IZ-Labs/RingRewards/README.md

# Welcome to Ring Rewards!
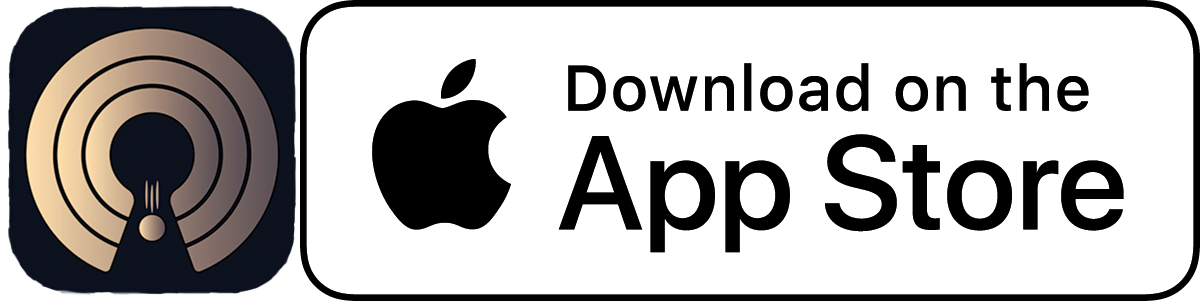
[picture p1: RingRewardsAppStoreBadge.png]


This is Ring Rewards, an IOS app that syncs your activity data using Apple's HealthKit, and uses that to determine if you've earned a candy reward.

<p>This is the culmination of about a project I've been working on in the background (very much on and off again) for over a year. It started as a 1 week design sprint during Mark Rober's Creative Engineering class on Studio, but ended up being a project that inspired me to learn how to make a PCB, how to program and release an IOS app with Swift and much much more.&nbsp;</p>
<p>The IOS app to accompany this device is available on the <a href="https://apps.apple.com/us/app/ring-rewards/id1584007591" target="_blank">App Store worldwide</a>, and the PCB Gerber files along with Arduino code are available on the linked <a href="https://github.com/CaptainZ1/RingRewards" target="_blank">GitHub repo.</a></p>
<p>The full video describing the design and build process is available here:</p>

<iframe width="560" height="315" src="https://www.youtube.com/embed/Qt_wYOnrX2E" title="YouTube video player" frameborder="0" allow="accelerometer; autoplay; clipboard-write; encrypted-media; gyroscope; picture-in-picture" allowfullscreen></iframe>

<p>The dispenser itself was designed with peanut covered MnMs in mind (who's non-uniform proportions really messed with my head for a while when focusing on one idea…), but the design should be <i>relatively</i> easily adapted to any similar sized candy.&nbsp;</p>
<p>In addition, I would encourage anyone who's interested in a fun project to try and design their own candy dispenser mechanics to go along with my app. It's a great intro project and will be a fun piece to have around.</p>

All models can be found on my printables.com page here: https://www.printables.com/model/229330-apple-fitness-candy-dispenser-ring-rewards

<p><strong>Build Instructions/BOM:</strong>&nbsp;</p>
<div class="table-wrapper"><figure class="table"><table><thead><tr><th>#</th><th>Part</th><th>QTY</th><th>Link (if applicable)</th><th>Material</th></tr></thead><tbody><tr><th>1</th><td style="text-align: center;">Front Body Panel</td><td style="width: 10px; text-align: center;">1</td><td style="width: 300px;">Printed Part</td><td style="width: 90px; text-align: center;">PLA</td></tr><tr><th>2</th><td style="text-align: center;">Rear Body Panel</td><td style="text-align: center;">1</td><td>Printed Part</td><td style="text-align: center;">PLA</td></tr><tr><th>3</th><td style="text-align: center;">Primary Dispenser Knob/Gear</td><td style="text-align: center;">1</td><td>Printer Part</td><td style="text-align: center;">PLA</td></tr><tr><th>4</th><td style="text-align: center;">28BYJ-48 &nbsp;ULN2003 &nbsp;5V Stepper Motor</td><td style="text-align: center;">1</td><td>Find the cheapest/easiest you can. They're everywhere</td><td style="text-align: center;">N/A</td></tr><tr><th>5</th><td style="text-align: center;">Secondary Dispenser Knob/Gear</td><td style="text-align: center;">1</td><td>Printed Part</td><td style="text-align: center;">PLA</td></tr><tr><th>6</th><td style="text-align: center;">Acrylic Panel</td><td style="text-align: center;">1</td><td>Laser Cut/Hand Cut</td><td style="text-align: center;">Acrylic</td></tr><tr><th>7</th><td style="text-align: center;">16mm Latching Push Button Switch</td><td style="text-align: center;">1</td><td>Find the cheapest/easiest you can. They're everywhere</td><td style="text-align: center;">N/A</td></tr><tr><th>8</th><td style="text-align: center;">Electronics PCB</td><td style="text-align: center;">1</td><td><a href="https://github.com/CaptainZ1/RingRewards/tree/main/PCB%20Files" target="_blank">Order From these files or use breadboard.</a></td><td style="text-align: center;">N/A</td></tr><tr><th>9</th><td style="text-align: center;">M3x0.5x6mm Screws</td><td style="text-align: center;">6</td><td><a href="https://www.mcmaster.com/97763A812/" target="_blank">McMaster</a>&nbsp;</td><td style="text-align: center;">18-8</td></tr><tr><th>10</th><td style="text-align: center;">M3 Heat Set Inserts</td><td style="text-align: center;">6</td><td><a href="https://www.mcmaster.com/94459A130/" target="_blank">McMaster</a></td><td style="text-align: center;">Brass</td></tr><tr><th>11</th><td style="text-align: center;">Loading Cap</td><td style="text-align: center;">1</td><td>Printed Part</td><td style="text-align: center;">TPU</td></tr><tr><th>12</th><td style="text-align: center;">Jam Clearing Rod</td><td style="text-align: center;">1</td><td>Printed Part</td><td style="text-align: center;">PLA</td></tr><tr><th>13</th><td style="text-align: center;">Jam Rod Retainer</td><td style="text-align: center;">1</td><td>Printed Part</td><td style="text-align: center;">PLA/PETG</td></tr><tr><th>14</th><td style="text-align: center;">Jam Rod Spring</td><td style="text-align: center;">1</td><td>8-10mm ID, &gt;20mm free length MIN</td><td style="text-align: center;">Misc. Metal</td></tr><tr><th>15</th><td style="text-align: center;">Command Strips</td><td style="text-align: center;">5</td><td>Velcro style 2-part command steps or similar</td><td style="text-align: center;">Adhesive</td></tr><tr><th>16</th><td style="text-align: center;">Superglue</td><td style="text-align: center;">N/A</td><td>Superglue or desired permanent adhesive</td><td style="text-align: center;">N/A</td></tr></tbody></table></figure></div>


<ol><li>Print all plastic components listed above in your desired color-ways (go wild!) and post-process as needed. It's a good idea to ream out the printed holes, especially for the jam clearing rod. Ensure all ordered components are on-hand before assembly.&nbsp;</li><li>Insert stepper motor (item 4) into the corresponding area on item 2. A *<i>light tap</i>*<i> </i>with a mallet may be required.</li><li>Insert the power button (item 7) into item 2.&nbsp;</li><li>Assemble primary gear (item 3) onto item 2-4 assembly (press firmly to ensure proper engagement.</li><li>Insert secondary gear (item 5) onto item 2 post. If desired, lightly mushroom the post after assembly using heat, but this is not required for function and may hamper cleaning efforts.&nbsp;</li><li>Attach PCB (item 8) using a command strip cut to size. Allows for easy servicing. Ensure power micro-usb connection is facing downwards. Solder connection to power button and plug-in the stepper motor.</li><li>Press in the heat set inserts (item 10) and allow to cool.</li><li>Depending on if you are right or left handed, choose a side to insert the jam clearing rod. Insert spring (item 14) into item 1 slot, then gently feed pusher rod (item 12) through the spring/slot and pin using item 13. Ensure function of mechanism before continuing.</li><li>If using a laser cut acrylic sheet, proceed. If cutting by hand, print the attached template (ensure your print scaling works properly…measure!!). Then glue to acrylic and cut using scissors. Sand edges as needed.&nbsp;</li><li>Remove protective film and instal acrylic panel (item 6). Secure using the M3 screws (item 9).</li><li>Bond Item 1 and Item 2 assemblies together using your preferred adhesive, using the alignment pegs of item 1 as a guide. Ensure glue coverage on the top section of the dispenser!</li><li>Allow glue to fully cure, cleaning excess as needed. Once cured (and you're happy enough to EAT off of it…I'm not responsible for any poisoning due to this project…); add your favorite candy!</li><li>Insert cap (item 11) to secure your food from prying fingers.&nbsp;</li><li>Download and update the Arduino code with your home wifi network SSID and password. During the initial setup, make sure you flash the arudino code onto your board and run it with the console open so you can read the IP address it connects to. This address should then be entered into the settings section of the iPhone app.</li><li>Get moving so you can earn some rewards!</li></ol>
