IZ-Labs/RingRewards/PCB Files/BOM_RingRewardsPCB2_2022-06-20.csv

ID | Name | Designator | Footprint | Quantity | Manufacturer Part | Manufacturer | Supplier | Supplier Part | Price
1 | nodeMCU | U2 | NODEMCU | 1
2 | 510 | R1 | R0603 | 1 | 0603WAF5100T5E | UniOhm | LCSC | C23193 | 0.001
3 | MICROXNJ | USB1 | MICRO-USB-SMD_MICROXNJ | 1 | MicroXNJ | SHOU HAN | LCSC | C404969 | 0.043
4 | 22uF | C1 | C0603 | 1 | CL10A226MQ8NRNC | SAMSUNG | LCSC | C59461 | 0.005
5 | 19-217/GHC-YR1S2/3T | LED1 | LED0603-R-RD | 1 | 19-217/GHC-YR1S2/3T | EVERLIGHT | LCSC | C72043 | 0.027
6 | ULN2003ADR | U3 | SOIC-16_L9.9-W3.9-P1.27-LS6.0-BL | 1 | ULN2003ADR | TI | LCSC | C7512 | 0.174
7 | B5B-XH-A-M(LF)(SN) | CN1 | CONN-TH_B5B-XH-AM-LF-SN | 1 | B5B-XH-A-M(LF)(SN) | JST Sales America | LCSC | C495550 | 0.129
