IZ-Labs/RingRewards/(commit log)

2021-08-31 further refinement of process flows. Minor UI changes. Added dedicated debugging view
2021-09-02 Added Arduino code for dispenser and logo art
2021-11-06 Added notifications to let you know when your rewards are going to expire, updated chance tab to give you better odds, and fixed a couple bugs across the board
2022-06-20 Added PCB V2 Manufacturing Files
    [BOM_RingRewardsPCB2_2022-06-20.csv, PickAndPlace_RingRewardsPCB2_2022-06-20.csv]
2022-06-25 Add files via upload
    updated Arduino code
